stardot/ArduinoFilestore/docs/README.md

# Index of documentation

- [Implemented Functions](https://github.com/stardot/ArduinoFilestore/blob/master/docs/Implemented.md) - An overview of what's working right now.
- [Filesystem Layout](https://github.com/stardot/ArduinoFilestore/blob/master/docs/Filesystem%20Layout.md) - How the SD card files and folder are used
