stardot/ArduinoFilestore/hardware/schematic.png

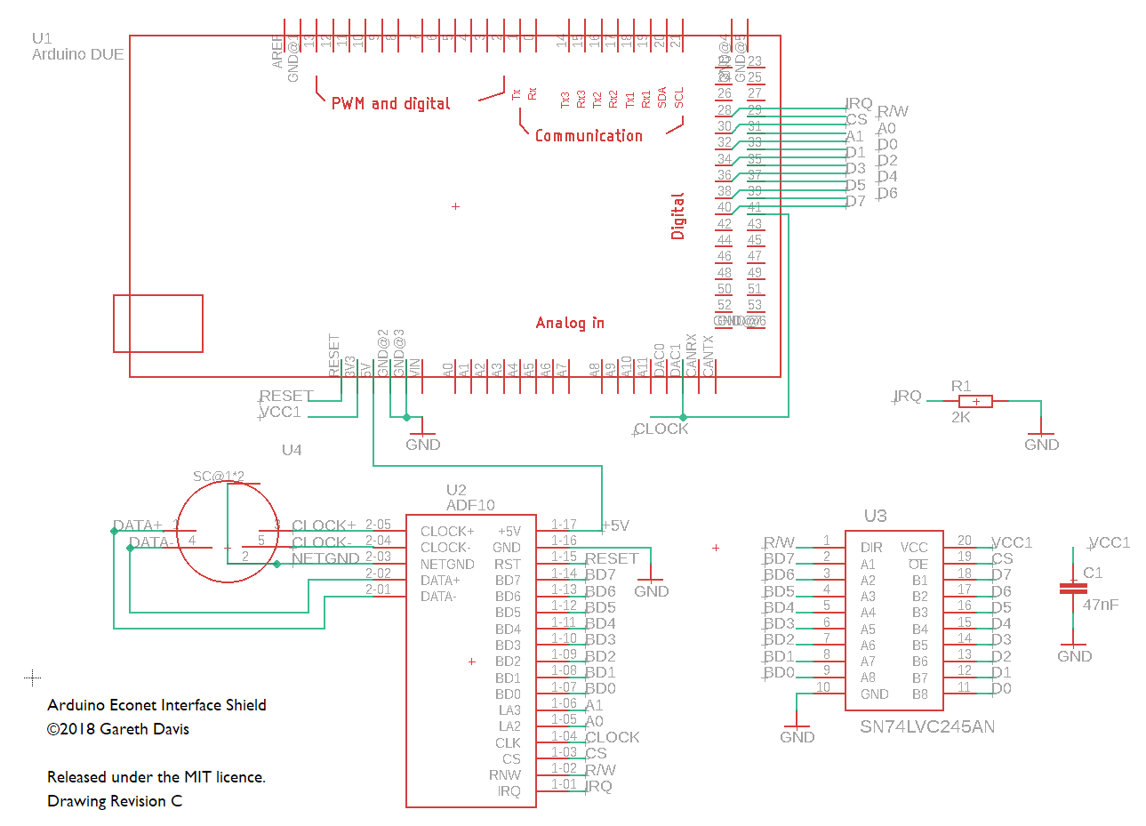
hardware/schematic.png
