stardot/ArduinoFilestore/(threads)

Thread 2 (2018-06-23):

Fix parsing of station number in *I AM

garethdavisbbc, 2018-06-23:
Currently logon is only supported in the form *I AM <user> <password>, this needs to be extended to allow for the optional station number.

garethdavisbbc, 2018-07-15:
Fixed in commit https://github.com/stardot/ArduinoFilestore/commit/f2d1e6a500d471d8d91008b98848d980560085f9

Closed 2018-07-15.

Thread 15 (2018-06-24):

*LOGON command not working

garethdavisbbc, 2018-06-24:
Use of the *LOGON command ceased working when user validation was added.

Logging on to server has been via *I AM command ever since.

garethdavisbbc, 2018-07-15:
Fixed in commit https://github.com/stardot/ArduinoFilestore/commit/f2d1e6a500d471d8d91008b98848d980560085f9

Closed 2018-07-15.

Thread 16 (2018-06-24):

Refactor code so no user settings are compiled in

garethdavisbbc, 2018-06-24:
Currently config details like network addresses are hard coded. These need to be moved into an external config file where they can be more easily changed by the user, and to also allow the same compiled code image to be dropped on multiple devices on the same network without causing conflicts.

garethdavisbbc, 2018-12-01:
Initial work in https://github.com/stardot/ArduinoFilestore/commit/a2f38c55bf73b4ea246fb31c452182bc5c04fe2b. Station, FSName and disk paths now held on disk. Need to add IP settings, Econet protocol timeout values and OSCLI commands to manipulate the disk settings.

garethdavisbbc, 2018-12-16:
Code is now in a position where the build can now be dropped on to multiple devices without causing Econet station, IP or MAC address conflicts - provided no conflicting values are already on disk.

garethdavisbbc, 2020-03-29:
Last of protocol settings have now been moved to config. Remaining compiled in values cannot easily be moved to config (they define global buffer sizes)

Closed 2020-03-29.

Thread 17 (2018-06-24):

Enforcement of file attributes

garethdavisbbc, 2018-06-24:
File attributes are not currently enforced, so locked, public and private bits have no meaning on files or folders. These will need to be checked on every single file operation carried out by the user.

garethdavisbbc, 2018-07-16:
Fixed in https://github.com/stardot/ArduinoFilestore/commit/0c327b83c71af17f794ce24a80f2fb4533454797

Closed 2018-07-16.

Thread 19 (2018-07-22):

Examine files sometimes returning $ instead of & folder.

garethdavisbbc, 2018-07-22:

garethdavisbbc, 2018-07-22:
Resolved in https://github.com/stardot/ArduinoFilestore/commit/949134d1f44727e98867e44f95fe48f042a78248

Closed 2018-07-22.

Thread 20 (2018-07-22):

FS Create File returning insufficient access in URD

garethdavisbbc, 2018-07-22:

garethdavisbbc, 2018-07-22:
Fixed in commit, added additional case for establishing file attributes.

Closed 2018-07-22.

Thread 24 (2019-01-06):

Transmitted frames contain 0xFF bytes in unexpected places

garethdavisbbc, 2019-01-06:
Some versions of the Arduino SAM support libraries / compiler break the very tight timing loops
this project depends on to talk to the ADLC. This manifests itself as the device being able to mostly decode frames correctly, but any transmission starts with one or more 0xFF bytes, and 0xFF bytes appear in unexpected places during the frame.

I'm currently building the sources with the 1.6.6 SAM Cortex support libraries. Newer libraries may be compatible (1.6.13 isn't), but I've not had a chance to pin down at which revision the problem is introduced.

I'm not convinced this is a problem with this project code, but how the compiler is optimising the code as it's building the project. As such it's a 'wontfix' until I learn otherwise.

Closed 2020-03-29.

Thread 27 (2019-02-01):

Add AUN support

garethdavisbbc, 2019-02-01:
Add support for frames encapsulated in Acorn Universal Networking (AUN) format over Ethernet
http://beebwiki.mdfs.net/index.php/Econet_over_IP

garethdavisbbc, 2020-04-14:
Basic AUN support now included. Issues to be tracked in new tickets

Closed 2020-04-14.

Thread 36 (2020-04-11):

Net address not being checked on Econet reception

garethdavisbbc, 2020-04-11:
The server is responding to an Econet frame addressed to the station number on any network, rather than just the network the station is directly connected to.

garethdavisbbc, 2020-04-12:
Fixed in commit

Closed 2020-04-12.

Thread 37 (2020-04-13):

Refactor port allocation for bulk transfers

garethdavisbbc, 2020-04-13:
Current implementation uses port 129+filehandle, but this falls over on the 24th file as the port clashes with the fileserver control port.

garethdavisbbc, 2020-04-13:
Fixed in commit

Closed 2020-04-13.

Thread 39 (2020-04-14):

FS Get Bytes fails to AUN addresses

garethdavisbbc, 2020-04-14:
FS Get Bytes from an AUN client shows 'completion Failed; in server console, and 'no reply' on client.

garethdavisbbc, 2020-04-19:
There is a UDP packet size limit in the hardware driver https://forum.wiznet.io/t/topic/5316
udp.write was successfully reporting TX of up to 2048 bytes, but payload hard limited to 1457.

Closed 2020-04-19.

Thread 45 (2020-05-08):

Review 4K Econet packet cap

garethdavisbbc, 2020-05-08:
Maximum Econet frame size of 4K is down to bridge hardware not being able to successfully transfer larger frames between networks. If a frame is destined for the local network, then larger frames can be utilised, and are by RiscOS machines.

Review code to only apply the 4K limit if Econet packet is destined for a remote network.

garethdavisbbc, 2020-05-11:
Fixed in commits

Closed 2020-05-11.

Thread 47 (2020-06-14):

Root relative paths not working for fixed users

garethdavisbbc, 2020-06-14:
From the Master Welcome suite, call to CHAIN "$.Utilities" in !Boot results in Bad Command.
User account set up with Fixed privs,

Server log:
`
16:27:26 0.10  FS Load  - user 0 object $.Utilities txport 146 working dir /export/MASTER object path /export/MASTER loadas 0 library object path /export/MASTER - Error 0xFE - Bad command - Error sent
`

garethdavisbbc, 2020-06-14:
Fixed in commit

Closed 2020-06-14.
