stardot/ArduinoFilestore/hardware/eagle/Board.brd

## EAGLE design hardware/eagle/Board.brd (2018-09-10)

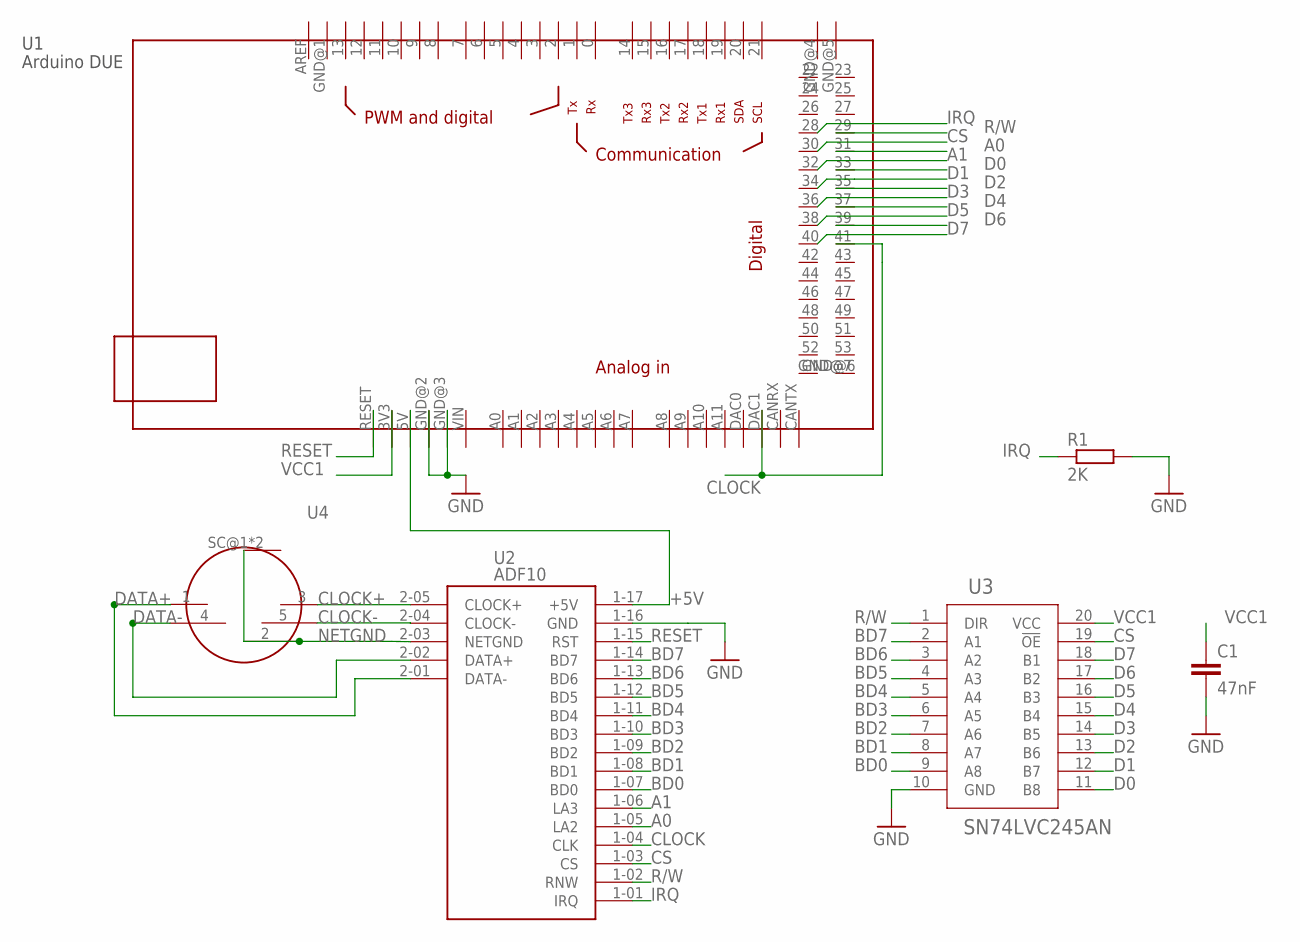
[picture p2: schematic Board.sch]

Parts:
C1: 47nF; C050-035X075
R1: 2K; 0309/12
U1: ARDUINODUE; MEGABOX
U2: ADF10
U3: SN74LVC245AN; N20
U4: 491087

Connections:
+5V: U1.5V, U2.1-17 (+5V)
A0: U1.31, U2.1-05 (LA2)
A1: U1.32, U2.1-06 (LA3)
BD0: U2.1-07 (BD0), U3.9 (A8)
BD1: U2.1-08 (BD1), U3.8 (A7)
BD2: U2.1-09 (BD2), U3.7 (A6)
BD3: U2.1-10 (BD3), U3.6 (A5)
BD4: U2.1-11 (BD4), U3.5 (A4)
BD5: U2.1-12 (BD5), U3.4 (A3)
BD6: U2.1-13 (BD6), U3.3 (A2)
BD7: U2.1-14 (BD7), U3.2 (A1)
CLOCK: U1.41, U1.DAC1, U2.1-04 (CLK)
CLOCK+: U2.2-05 (CLOCK+), U4.3
CLOCK-: U2.2-04 (CLOCK-), U4.5
CS: U1.30, U2.1-03 (CS), U3.19 (!OE)
D0: U1.33, U3.11 (B8)
D1: U1.34, U3.12 (B7)
D2: U1.35, U3.13 (B6)
D3: U1.36, U3.14 (B5)
D4: U1.37, U3.15 (B4)
D5: U1.38, U3.16 (B3)
D6: U1.39, U3.17 (B2)
D7: U1.40, U3.18 (B1)
DATA+: U2.2-01 (DATA-), U4.1
DATA-: U2.2-02 (DATA+), U4.4
GND: C1.2, R1.2, U1.GND@2 (GND), U1.GND@3 (GND), U2.1-16 (GND), U3.10 (GND)
IRQ: R1.1, U1.28, U2.1-01 (IRQ)
NETGND: U2.2-03 (NETGND), U4.2, U4.SC@1 (SHIELD), U4.SC@2 (SHIELD)
R/W: U1.29, U2.1-02 (RNW), U3.1 (DIR)
RESET: U1.RESET, U2.1-15 (RST)
VCC1: C1.1, U1.3V3, U3.20 (VCC)

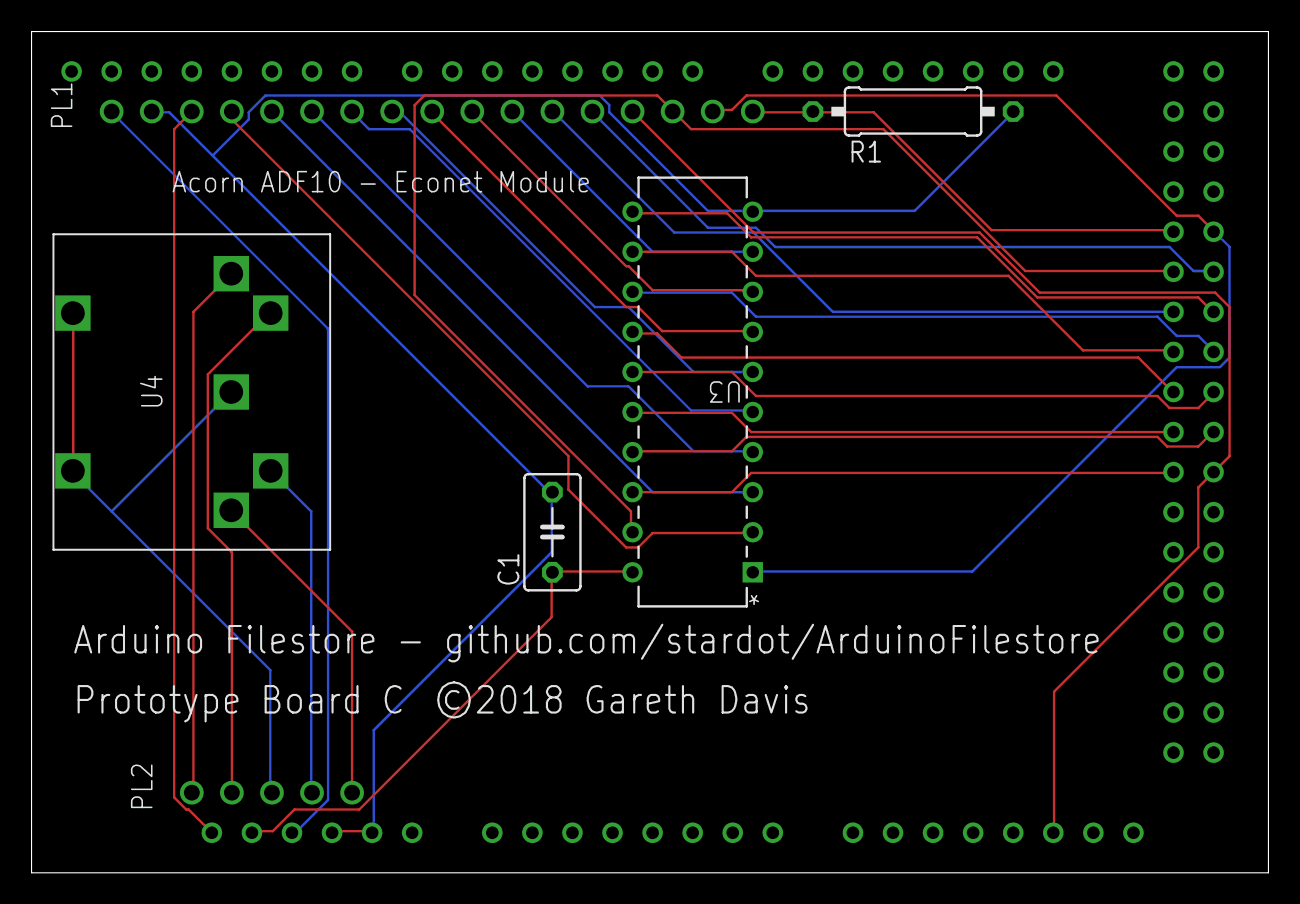
[picture p3: board Board.brd from above]

Board: 2 copper layers, 78.4 x 53.3 mm, 6 parts (0 on the bottom side), 31 nets.
