stardot/ArduinoFilestore/EconetServer/EconetServer.ino

// Arduino Due Econet Module interface

#include <SPI.h>
#include <Ethernet.h>
#include "SdFat.h"
#include <time.h>
#include <TimeLib.h>

// Configuration root folder
String config_confRoot="/config";

// Econet station will be read from config folder specified above, if missing will default to value here
byte config_Station=170;
byte config_Net=0; // TODO: Not strictly speaking config, Needs a bridge discovery to fix this later on

// Other config options defaults defined as they are read in.
String config_FSRoot, config_MetaRoot, config_ProfileRoot, config_FSName;
String config_etherMAC, config_IP, config_Netmask, config_DNS, config_Gateway, config_NTPserver;

// Config values that have to be compiled in
#define BUFFSIZE 16384 // Size of TX, RX and work buffers
#define MAXDEPTH 25 // Maximum directory depth supported in CSD/LIB path
#define DIRENTRYSIZE 277 // (MAXDEPTH*11+2) - each directory has 10 chars plus a seperator. Also complete string has a root and terminating character.
#define MAXFILES 100 // Total maximum number of files and folders open
#define MAXUSERS 10 // Total number of user sessions
#define MAXAUNPACKET 1460 // 1460 Maximum AUN packet size due to W5100 stack (https://forum.wiznet.io/t/topic/5316)
#define MAXAUNNETWORKS 5 // Maximum number of AUN networks on network map

IPAddress timeServer;

EthernetUDP aunUdp;
unsigned int aunUDPsrcPort = 0x8000;  // AUN udp local port
IPAddress currentAUNrxIP;
unsigned long aunSeqNo = 0;

EthernetUDP ntpUdp;
unsigned int ntpUDPsrcPort = 8888;  // NTP udp local port (not used)

//Profile structure
#define PROFILE_PRIV 0
#define PROFILE_OPTS 1
#define PROFILE_ENABLED 2
#define PROFILE_PASSWORD 3
#define PROFILE_QUOTA 26
#define PROFILE_BALANCE 30
#define PROFILE_URD 34

// Map the 17 Econet module pins to Arduino GPIO pins. D0-D8 are aligned with 8 contiguous bits on a port 
#define PIN_IRQ 28  // Econet module pin 1
#define PIN_RnW 29  // Econet module pin 2
#define PIN_Cs 30   // Econet module pin 3
#define PIN_Cf 41   // Econet module pin 4 - Clock feedback pin, also attached to clock on DAC1
#define PIN_Rs0 31  // Econet module pin 5
#define PIN_Rs1 32  // Econet module pin 6
#define PIN_D0 33   // Econet module pin 7
#define PIN_D1 34   // Econet module pin 8
#define PIN_D2 35   // Econet module pin 9 
#define PIN_D3 36   // Econet module pin 10
#define PIN_D4 37   // Econet module pin 11
#define PIN_D5 38   // Econet module pin 12
#define PIN_D6 39   // Econet module pin 13
#define PIN_D7 40   // Econet module pin 14
                    // Econet module pin 15 reset - linked to board reset line
                    // Econet module pin 16 gnd
                    // Econet module pin 17 +5v

#define SD_SPI_PIN 4
#define ETHER_SPI_PIN 10
#define SPI_SPEED SD_SCK_MHZ(24) // TODO: Need to fine tune this

byte rxBuff[BUFFSIZE];
byte txBuff[BUFFSIZE];
byte scoutBuff[8];
byte ackBuff[8];
byte workBuff[BUFFSIZE+8]; // Allow for larger AUN frames
char pathBuff1[DIRENTRYSIZE];
char pathBuff2[DIRENTRYSIZE];
char pathBuff3[DIRENTRYSIZE];
char pathBuff4[DIRENTRYSIZE];
char confBuff[255];
boolean portInUse[255];
char fileToPort[MAXFILES];
char portToFile[255];
byte aunNetMap[MAXAUNNETWORKS*4];
boolean w5500card;


boolean busWrite = false; // Global flag to indicate data bus direction

byte rxPort = 255;
byte rxControlByte=255;
boolean gotScout=false;


// Reserve space for server tables
char userURD[DIRENTRYSIZE*MAXUSERS];
byte netaddress[MAXUSERS];
byte stataddress[MAXUSERS];
byte userCSDhdl[MAXUSERS];
byte userLibhdl[MAXUSERS];
int userOpenFiles[MAXUSERS];
char userName[MAXUSERS*22]; // two level username of 10 chars, plus seperator, plus string termination
byte userPriv[MAXUSERS];
 
// Reserve space for filesystem tables
SdFat sd; // Card file system object.
FatFile fHandle[MAXFILES]; // Table of open filehandles
boolean fHandleActive[MAXFILES]; // Is this file handle currently active in the table?
char fHandlePath[DIRENTRYSIZE*MAXFILES]; // Path of the open file / folder
int fHandleUser[MAXFILES]; // Which user ID owns this filehandle
boolean fHandleIsFolder[MAXFILES]; // Is this an open folder, not a file?
byte fSequence[MAXFILES]; // Sequence number used in file transfers
byte dataAckPort[MAXFILES]; // Acknowledge port used in bulk uploads
byte dataReplyPort[MAXFILES]; // Reply port used in bulk uploads
int expectingBytes[MAXFILES]; // No of bytes to expect in a bulk upload
int gotBytes[MAXFILES]; // No if bytes so far in a bulk upload
boolean isSave[MAXFILES]; // Is the bulk upload a save (function 1) operation?

// Protocol retries and timeouts
int scoutTimeout; // Milliseconds to wait for second part of scout during RX 
int ackTimeout; // mS to wait for scout or payload ack to arrive during TX
int txBeginTimeout; // Milliseconds to wait for network to become ready to TX frame before reporting line jammed
int txRetries; // Number of times to retry a failed frame TX before reporting failed
int txRetryDelay; //mS to wait between frame retries
int maxUserFiles; // Maximum files open per login

void setup() {
  
  Serial.begin(115200); // Make sure this matches your console, otherwise you will get no further running this!
  
  while (!Serial) {
    ; // wait for serial console to connect
  }

  Serial.println("Reset!");
  
  // Set initial pin config
  pinMode (PIN_LED, OUTPUT);
  digitalWriteDirect(PIN_LED,0);
  pinMode (PIN_RnW, OUTPUT);
  pinMode (PIN_IRQ, INPUT);
  pinMode (PIN_Cs, OUTPUT);
  digitalWriteDirect(PIN_Cs,1); //Deselect controller (active low)
  pinMode (PIN_Rs0, OUTPUT);
  pinMode (PIN_Rs1, OUTPUT);
  pinMode (PIN_Cf, INPUT);
  
  busWrite=false; // set busWrite to force busWriteMode to execute
  busWriteMode(); // Set databus to output mode 
  
  // PWM 2Mhz Clock Set-up on pin DAC1 for ADLC clock
  REG_PMC_PCER1 |= PMC_PCER1_PID36;                     // Enable PWM
  REG_PIOB_ABSR |= PIO_ABSR_P16;                        // Set pin perhipheral type B
  REG_PIOB_PDR |= PIO_PDR_P16;                          // Set PWM pin to an output - PIO_PB16X1_DAC1
  REG_PWM_CLK = PWM_CLK_PREA(0) | PWM_CLK_DIVA(1);      // Set the PWM clock rate to 84MHz (84MHz/1)
  REG_PWM_CMR0 = PWM_CMR_CPRE_CLKA;                     // Enable single slope PWM and set the clock source as CLKA
  REG_PWM_CPRD0 = 42;                                   // Set the PWM frequency 84MHz/2Mhz = 42
  REG_PWM_CDTY0 = 21;                                   // Set the PWM duty cycle 50% (42/2=21)
  REG_PWM_ENA = PWM_ENA_CHID0;                          // Enable the PWM channel     

  //Set up the SPI pins
  pinMode (SD_SPI_PIN,OUTPUT);
  pinMode (ETHER_SPI_PIN,OUTPUT);
  digitalWriteDirect(SD_SPI_PIN,1);
  digitalWriteDirect(ETHER_SPI_PIN,1);

  // Now do the SD card stuff
  sdSelect();
  if (!sd.begin(SD_SPI_PIN, SPI_SPEED)) {
    // Check for possible errors
    if (sd.card()->errorCode()) {
      Serial.print("Serial initialisation failed error code: ");
      Serial.print (sd.card()->errorCode(),HEX);
      Serial.print(", data: ");
      Serial.print (sd.card()->errorData(),HEX);
      Serial.println();    
    }
    if (sd.vol()->fatType() == 0) Serial.println("Can't find a valid FAT16/FAT32 partition.");

    if (!sd.vwd()->isOpen()) Serial.println("Can't open root directory.\n");      

   Serial.println("Halting due to SD card initialisation error");
   while(1){ };
  }


  uint32_t size = sd.card()->cardSize();
  if (size == 0) {
    Serial.println("Can't determine card size");
  } else {
    uint32_t sizeMB = 0.000512 * size + 0.5;
    Serial.print("Card size is "); 
    Serial.print(sizeMB);
    Serial.print("MB, Volume is FAT");
    Serial.print(sd.vol()->fatType());
    Serial.print(", Cluster size (bytes): ");
    Serial.print(512L * sd.vol()->blocksPerCluster());
    Serial.print(", Free space (bytes): ");
    uint32_t freeBytes=(512L * sd.vol()->blocksPerCluster())*sd.vol()->freeClusterCount();
    Serial.println(freeBytes);
  }

  Serial.println("SD card initialisation completed, Loading config from card...");

  config_confRoot.toCharArray(pathBuff1, 255);
  if(!sd.exists(pathBuff1)){
    if(sd.mkdir(pathBuff1)) Serial.println("Created FS Configuration directory"); else Serial.println("FS root not present, and failed to mkdir");  
  }


//sd.remove("/config/Station");
//sd.remove("/config/FSName");
//sd.rmdir("/profile");

  // Load configuration from card, or apply default values if missing
  config_FSRoot=readConfigValue("FSRoot");
  if (config_FSRoot.length()==0) {
    config_FSRoot="/export"; 
    writeConfigValue("FSRoot",config_FSRoot);
  }
 
  config_MetaRoot=readConfigValue("MetaRoot");
  if (config_MetaRoot.length()==0) {
    config_MetaRoot="/meta";
    writeConfigValue("MetaRoot",config_MetaRoot);
  }

  config_ProfileRoot=readConfigValue("ProfileRoot");
  if (config_ProfileRoot.length()==0) {
    config_ProfileRoot="/users";
    writeConfigValue("ProfileRoot",config_ProfileRoot);
  }   
  
  config_FSRoot.toCharArray(pathBuff1, 255);
  if(!sd.exists(pathBuff1)){
    if(sd.mkdir(pathBuff1)) Serial.println("Created FS Root directory"); else Serial.println("FS root not present, and failed to mkdir "+config_FSRoot);  
  }

  config_MetaRoot.toCharArray(pathBuff1, 255);
  if(!sd.exists(pathBuff1)){
    if(sd.mkdir(pathBuff1)) Serial.println("Created FS metadata directory"); else Serial.println("FS metadata folder not present, and failed to mkdir "+config_MetaRoot);  
  }

  config_ProfileRoot.toCharArray(pathBuff1, 255);

  if(!sd.exists(pathBuff1)){
    if(sd.mkdir(pathBuff1)) {
      Serial.println("Created FS user profile directory");
      String userProfile=config_ProfileRoot+"/SYST";
      userProfile.toCharArray(pathBuff1, DIRENTRYSIZE);
      if (fHandle[0].open(pathBuff1, (O_RDWR | O_CREAT))){
        Serial.println("Creating default user");

        workBuff[PROFILE_PRIV]=255;     // Privilege is System
        workBuff[PROFILE_OPTS]=0;       // boot options
        workBuff[PROFILE_ENABLED]=1;    // Can login
        workBuff[PROFILE_PASSWORD]=0;   // No password
        // Allow 22 characters for the password to expand 
        workBuff[PROFILE_QUOTA]=0;      // Quota not used
        workBuff[PROFILE_QUOTA+1]=0;    // Quota not used
        workBuff[PROFILE_QUOTA+2]=0;    // Quota not used
        workBuff[PROFILE_QUOTA+3]=0;    // Quota not used
        workBuff[PROFILE_BALANCE]=0;    // Quota not used
        workBuff[PROFILE_BALANCE+1]=0;  // Quota not used
        workBuff[PROFILE_BALANCE+2]=0;  // Quota not used
        workBuff[PROFILE_BALANCE+3]=0;  // Quota not used
        workBuff[PROFILE_URD]=47;       // User directory is / (ASCII 47)
        workBuff[PROFILE_URD+1]=0;      // User directory termination
        
        fHandle[0].write(&workBuff,PROFILE_URD+2);
        fHandle[0].close();
      } else {
        Serial.println("Failed to create default user in "+userProfile);
      }
    }
    else Serial.println("FS profile folder not present, and failed to mkdir "+config_ProfileRoot);  
  }

  int config_Station_Temp=readConfigValueAsInt("Station");;
  if (config_Station_Temp < 2 || config_Station_Temp > 254) {
    Serial.println("Station number invalid, using "+String(config_Station)+" instead");
  } else {
    config_Station=(byte)config_Station_Temp;
  }

  Serial.println("Station is "+String(config_Net)+"."+String(config_Station));

  config_FSName=readConfigValue("FSName");
  if (config_FSName.length()==0 || config_FSName.length()>16) {
    config_FSName="Arduino"+String(config_Station);
  }   

  Serial.println("Disc name is "+String(config_FSName)+".");

  byte mac[] = {0, 0, 0, 0, 0, 0};
  config_etherMAC=readConfigValue("MAC");
  config_etherMAC.toCharArray(confBuff,18);  
  sscanf(confBuff, "%x:%x:%x:%x:%x:%x", mac, mac + 1, mac + 2, mac + 3, mac + 4, mac + 5);
  
  if (mac[0]+mac[1]+mac[2]+mac[3]+mac[4]+mac[5] == 0) {
    Serial.println("Invalid ethernet MAC address configured, "); 
    mac[2] = 0xa4; // 00:00:A4 = Acorn MAC address allocation
    mac[4] = config_Net;
    mac[5] = config_Station;
  } 
  Serial.println ("Using ethernet MAC address "+String(mac[0],HEX)+":"+String(mac[1],HEX)+":"+String(mac[2],HEX)+":"+String(mac[3],HEX)+":"+String(mac[4],HEX)+":"+String(mac[5],HEX));

  byte ip[] = {0, 0, 0, 0};
  config_IP=readConfigValue("IP");
  config_IP.toCharArray(confBuff,16);  
  sscanf(confBuff, "%u.%u.%u.%u", ip, ip + 1, ip + 2, ip + 3);
  
  if (ip[0]+ip[1]+ip[2]+ip[3] == 0) {
    Serial.println("Invalid IP address configured, using DHCP to get IP..."); 
      if (config_IP.length()==0) writeConfigValue("IP","0.0.0.0");    // Default to DHCP
    etherSelect();
    Ethernet.begin(mac); 
  }  else {

    byte mask[] = {0, 0, 0, 0};
    config_Netmask=readConfigValue("Netmask");
    config_Netmask.toCharArray(confBuff,16);  
    sscanf(confBuff, "%u.%u.%u.%u", mask, mask + 1, mask + 2, mask + 3);
  
    if (mask[0]+mask[1]+mask[2]+mask[3] == 0) {
       Serial.println("Netmask not set, using 255.255.255.0");    
       mask[0]=255;
       mask[1]=255;
       mask[2]=255;
       writeConfigValue("Netmask","255.255.255.0"); 
    }

 
    byte dns[] = {0, 0, 0, 0};
    config_DNS=readConfigValue("DNS");
    config_DNS.toCharArray(confBuff,16);  
    sscanf(confBuff, "%u.%u.%u.%u", dns, dns + 1, dns + 2, dns + 3);
  
    if (dns[0]+dns[1]+dns[2]+dns[3] == 0) {
       Serial.println("DNS not set, using 8.8.8.8");    
       dns[0]=8;
       dns[1]=8;
       dns[2]=8;
       dns[3]=8;
       writeConfigValue("DNS","8.8.8.8");
    }

    byte gateway[] = {0, 0, 0, 0};
    config_Gateway=readConfigValue("Gateway");
    config_Gateway.toCharArray(confBuff,16);  
    sscanf(confBuff, "%u.%u.%u.%u", gateway, gateway + 1, gateway + 2, gateway + 3);

    if (gateway[0]+gateway[1]+gateway[2]+gateway[3] == 0) {
       Serial.println("Gateway not set, using 0.0.0.0");    
       writeConfigValue("Gateway","0.0.0.0"); 
    }
      
    etherSelect();
    Ethernet.begin(mac,ip,dns,gateway,mask); 
  }    
 
  if (Ethernet.hardwareStatus() == EthernetW5500) {
    Serial.println("W5500 Ethernet controller detected.");
    w5500card=true;
  } else w5500card=false;

  Serial.print("Ethernet maximum sockets: ");  
  Serial.print(MAX_SOCK_NUM);  
#if defined(ETHERNET_LARGE_BUFFERS)
  Serial.print(" - large buffer support enabled");
#endif
  Serial.println("");
   
  Serial.print("Ethernet config complete - IP address: ");
  Serial.println(Ethernet.localIP());


  
  // Initialise the AUN mapping table- this needs to go into config
  IPAddress myIP=Ethernet.localIP();

  Serial.println("Building default AUN table ");
  aunNetMap[0]=128; // mapped network
  aunNetMap[1]=myIP[0];
  aunNetMap[2]=myIP[1];
  aunNetMap[3]=myIP[2];
  aunNetMap[4]=0; // End of table

  sprintf(confBuff,"%u.x = %u.%u.%u.x",aunNetMap[0],aunNetMap[1],aunNetMap[2],aunNetMap[3]);
  Serial.println(confBuff);
  
  if (!aunUdp.begin(aunUDPsrcPort)){
    Serial.println("AUN UDP port open failed - halting ");
    while (1);  
  }
  Serial.println("AUN UDP port opened ");

  config_NTPserver=readConfigValue("NTP");
  byte ntpserver[] = {0, 0, 0, 0}; 
  config_NTPserver.toCharArray(confBuff,16);  
  sscanf(confBuff, "%u.%u.%u.%u", ntpserver, ntpserver + 1, ntpserver + 2, ntpserver + 3);
  
  if (ntpserver[0]+ntpserver[1]+ntpserver[2]+ntpserver[3] == 0) {
    Serial.print("NTP server not configured, skipping clock sync");
    writeConfigValue("NTP","0.0.0.0");    
  } else {

    timeServer[0]=ntpserver[0];
    timeServer[1]=ntpserver[1];
    timeServer[2]=ntpserver[2];
    timeServer[3]=ntpserver[3];
        
    ntpUdp.begin(ntpUDPsrcPort);
    Serial.println("Waiting for NTP time sync from "+String(ntpserver[0])+"."+String(ntpserver[1])+"."+String(+ntpserver[2])+"."+String(+ntpserver[3])+"...");
  
    int attempt=1;
    setSyncProvider(getNtpTime);
    setSyncInterval(86400); // Once a day

    while (attempt<4 && timeStatus() != timeSet){
      setSyncProvider(getNtpTime);
      attempt++;
    }
    if (year()<1981){
      Serial.println ("Bumping time to Econet epoch");
      setTime(0,0,0,1,1,1981);
    }
    
    printTime();
    Serial.print(" ");
    printDate();
    Serial.println("");
  }

  if (readConfigValue("ScoutTimeout").toInt()==0){
    Serial.print("Setting default value for scoutTimeout, ");
    scoutTimeout=100;
    writeConfigValue("ScoutTimeout","100");
  } else {
    scoutTimeout=readConfigValue("ScoutTimeout").toInt();
  }

  if (readConfigValue("AckTimeout").toInt()==0){
    Serial.print("Setting default value for ackTimeout, ");
    ackTimeout=200;
    writeConfigValue("AckTimeout","200");
  } else {
    ackTimeout=readConfigValue("AckTimeout").toInt();
  }

  if (readConfigValue("TxBeginTimeout").toInt()==0){
    Serial.print("Setting default value for TxBeginTimeout, ");
    txBeginTimeout=5000;
    writeConfigValue("TxBeginTimeout","5000");
  } else {
    txBeginTimeout=readConfigValue("TxBeginTimeout").toInt();
  }


  if (readConfigValue("TxRetries").toInt()==0){
    Serial.print("Setting default value for TxRetries, ");
    txRetries=5;
    writeConfigValue("TxRetries","5");
  } else {
    txRetries=readConfigValue("TxRetries").toInt();
  }

  if (readConfigValue("TxRetryDelay").toInt()==0){
    Serial.print("Setting default value for TxRetryDelay, ");
    txRetryDelay=50;
    writeConfigValue("TxRetryDelay","50");
  } else {
    txRetryDelay=readConfigValue("TxRetryDelay").toInt();
  }

 if (readConfigValue("MaxUserFiles").toInt()==0){
    Serial.print("Setting default value for MaxUserFiles, ");
    maxUserFiles=10;
    writeConfigValue("MaxUserFiles","10");
  } else {
    maxUserFiles=readConfigValue("MaxUserFiles").toInt();
  } 

  Serial.println("Config load completed");
   
  // Attaching SD filesystem callback for RTC
  SdFile::dateTimeCallback(dateTimeCB);
  
  // Initialise the Econet interface
  Serial.print("Initialising Econet controller....");
  initADLC();
  printSR1(readSR1());
  Serial.println(" done.");

  int ptr=0;

  // Initialise the user tables
  for (ptr=0; ptr<MAXUSERS; ptr++){
    stataddress[ptr]=0;
    netaddress[ptr]=0;
  }  

  // Initialise the file tables
  for (ptr=0; ptr<MAXFILES; ptr++){
    fHandleActive[ptr]=false;    
    fHandleUser[ptr]=-1;    
    fileToPort[MAXFILES]=0;
  }  
  
  // Initialise the file to port mapping
  for (ptr=0; ptr<256; ptr++){
    portInUse[ptr]=false;
  }
  portInUse[0x99]=true; // Mark fileserver port in use



}


void loop() {
  unsigned long nextEvent,LCDupdate=0;
  byte statReg1, statReg2;
  boolean ledStatus=false, inFrame=false;
  int bufPtr=0, frameAddr=0, udpPacketSize=0;
  String lcdTime;

  // TODO: Bridge discovery, and set net address
  busWriteMode();
  listFS();
  busReadMode();

//  Serial.println("\r\n--------------------------\r\nEntering main loop");
    Serial.println("\r\n------------------\r\nEntering main loop");

  nextEvent=millis()+1000;

  while (1){ // Enter main event loop

    if (!digitalReadDirect(PIN_IRQ)){
      //There is an Econet IRQ to service
      statReg1=readSR1();
 
      if (statReg1 & 2){
        // SR2 needs servicing
        statReg2=readSR2();

        if (statReg2 & 1) { rxFrame(); };               // Address present in FIFO, so fetch it and the rest of frame
        if (statReg2 & 2 ) { readFIFO(); resetIRQ(); }; // Frame complete - not expecting a frame here, so read and discard 
        if (statReg2 & 4 ) { resetIRQ(); gotScout=false; };  // Inactive idle - clear open rx
        if (statReg2 & 8 ) { resetIRQ(); };             // TX abort received - not inside a frame here, so clear it 
        if (statReg2 & 16 ) { resetIRQ(); };            // Frame error - not inside a frame here, so clear it 
        if (statReg2 & 32) { Serial.println("No clock!"); resetIRQ(); }; // Carrier loss
        if (statReg2 & 64) { resetIRQ(); };             // Overrun - not inside a frame here, so clear it 
        if (statReg2 & 128) { readFIFO(); };            // RX data available - not inside a frame here, so read and discard it
 
      } else {
 
        //Something else in SR1 needs servicing        
        if (statReg1 & 1) { readFIFO(); }; // Not expecting data, so just read and ignore it!
        resetIRQ(); //Reset IRQ as not expecting anything!

      } // end of SR2 servicing
    } // end of IRQ to service

    // Check for AUN packets
    etherSelect();
    udpPacketSize=aunUdp.parsePacket();
    if (udpPacketSize) aunRXframe(udpPacketSize);

    // Write clock to console (confidence display that code is still running)
    if (millis()>nextEvent){
      printTime();
      Serial.print("\r");
      nextEvent=millis()+1000;
    }
  } // end of event loop  
} // Program loop
