stardot/ArduinoFilestore/(commit log)

2018-03-31 schematic drawing
2018-06-22 Adjusted timeouts, and dropped CSD and lib handle caching.
    Amended protocol timeouts and associated error messages
    Removed internal caching of CSD and Library handles per user, now the handles in the TX header are always used.
    [Econet.ino, EconetServer.ino, Fileserver.ino]
2018-06-23 Added back in setURD during login removed in error in last commit
    [Fileserver.ino]
2018-07-15 Fixing of bugs #2 and #15
    Fixing of bugs #2 and #15 by refactoring the parsing of logon parameters.
    [Fileserver.ino]
2018-07-22 Examine not returning & #19
    Implimented missing function
    [Fileserver.ino]
2018-07-22 Fix for insufficient access when creating file #20
    Added case to provide default attributes when querying against a non existant file
    [Fileserver.ino]
2018-07-22 Fix for #21
    Added correct behaviour for *DIR and *LIB when executed without a parameter
    [Fileserver.ino]
2018-09-10 Uploaded hardware schematics and gerber files.
    [Board.brd, Board.sch]
2018-12-16 Additional refactoring of hardcoded config values
    Config defaults moved to top of code.
    Station config moved to a byte, to allow removal of additional toInt() steps that were affecting program timings.
    Also version of Arduino IDE changed, which has introduced numerous formatting changes.
2019-01-06 Changes to diagnose frame timing issues
    Made timeout to receive an ACK during tx configurable, and report ack timeouts to console.
    Altered existing timeout to closer match those RISCOS NetFS uses by default
    Added additional debug message when FS operation complete.
    [Econet.ino, EconetServer.ino, Fileserver.ino]
2019-01-06 Reduce privs of fixed and locked users #23
    User privilege now cached in memory
    Fixed and Locked users now unable to set password, or call function 22 (set boot options)
    [EconetServer.ino, Fileserver.ino]
2019-01-06 Fixed multiple regressions discovered in #22
    [Fileserver.ino]
2019-01-06 Fixed further regressions identified in #22
    Enforcement of rights on file open and create now working again.
    [Fileserver.ino]
2019-01-06 Fixed LoadAs function
    Function was not checking the correct library path, nor enforcing permissions correctly.
    [Fileserver.ino]
2019-01-07 LoadAs symantics modified, console cleanup
    LoadAs function updated to match the error symantics of Level 4
    A couple of console messages truncated to improve the readibility
    [Econet.ino, Fileserver.ino]
2019-01-07 Fixes for Set Attributes not working on preexisting folders #25
    createMetaFile being called with metafile path, not object path.
    Refactored code to store metafile and object path in different strings.
    [Fileserver.ino]
2019-01-07 Fixes for a number of cases where ownership of objects was not correctly determined #26
    [Fileserver.ino]
2019-01-08 Fix for loss of file attributes when saving file
    [Fileserver.ino]
2019-01-26 Added *SDISC command, made changes to error reporting
    *SDISC command added, so it's now possible to complete a base NetFS installation on PANOS on the server.
    Also automatic frame TX retries are no longer reported on in server console. Frequent seem to be normal behaviour in an Econet environment, and the client side NetFS interface also does not report them.
    Also the network buffer has been raised form 4K to 16K, which improves throughput of larger files on RISC OS machines
    [Econet.ino, EconetServer.ino, Fileserver.ino]
2019-03-31 Fix for #31, enable BYE from OSCLI interface
    [Fileserver.ino]
2019-03-31 Added missing format to Examine object command
    [Fileserver.ino]
2020-03-09 Changes to error messages
    [Fileserver.ino]
2020-03-10 Network idle resets scout received state, ignore unexpected packets
    [Econet.ino, EconetServer.ino]
2020-03-28 Removed the writing of invalid config defaults on startup for #31
    Also fixed the message shown when the Gateway is defaulted
    [EconetServer.ino]
2020-03-28 Revert "Removed the writing of invalid config defaults on startup for #31"
    This reverts commit 6e38d3a6dea326da694635208e97cba288cf9fef.
    [EconetServer.ino]
2020-03-28 Revert "Revert "Removed the writing of invalid config defaults on startup for #31""
    This reverts commit 4abd7b5405f040525f10b5735e2f2e8074743089.
    [EconetServer.ino]
2020-03-28 Revert "Revert "Revert "Removed the writing of invalid config defaults on startup for #31"""
    This reverts commit 535b87392e50063b2e5b00f3dca96ab672ca1909.
    [EconetServer.ino]
2020-04-11 Added framework for AUN UDP packet reception
2020-04-11 Fixed post compile typo
    [AUN.ino]
2020-04-12 Fixed AUN packet display looking at wrong buffer
    [AUN.ino]
2020-04-13 First cut of AUN packet TX and RX routines for #27
2020-04-19 AUN implementation changes, and fix to machinepeek version
    [AUN.ino, Econet.ino]
2020-05-03 Packet size fix for #41
    [Fileserver.ino]
2020-05-03 Tweaks to error messages, and fix for fsshutdown waking up.
    [Fileserver.ino]
2020-05-04 Fix for bulk transfers sometimes sending more bytes than expected #42, and additional debug
    [Fileserver.ino]
2020-05-05 Additional debug statemants and rework of put bytes for #44
    [Fileserver.ino]
2020-05-08 Changes to econet max frame logic for #45
2020-05-11 Added missing & folder handling #43
    [EconetServer.ino, Fileserver.ino]
2020-05-11 Changed position of & rewrite in logic flow to benefit all functions #43
2020-05-11 Chroot for fixed users, and & reliative paths #23
    [Fileserver.ino]
2020-05-13 Implmented action 1 on Set Random Access Args, plus other fixes for #44
    [Fileserver.ino]
2020-05-13 Fixes for #46 - zero byte save failing
    [Fileserver.ino]
2020-05-13 Compiler alignment bug workaround
    [EconetServer.ino]
2020-06-14 Fix for $ mapping for fixed users #47
    [Fileserver.ino]
2020-06-14 Reduced verbosity of common failures
    [AUN.ino, Econet.ino]
2020-06-14 Added W5500 card detection, bumped RTC to Econet Epoch if fails to sync with NTP
    [EconetServer.ino]
2020-06-14 Added AUN map support with fixed default table #40
    [AUN.ino, Econet.ino, EconetServer.ino, Fileserver.ino]
2020-08-05 Synced hardware schematic with Eagle files
