stardot/ArduinoFilestore/(notices)

Notices in the files:
hardware/eagle/Board.brd:
©2018 Gareth Davis
